JTech-CO/Smart-Cart-4/assets/reference/servo-performance.webp

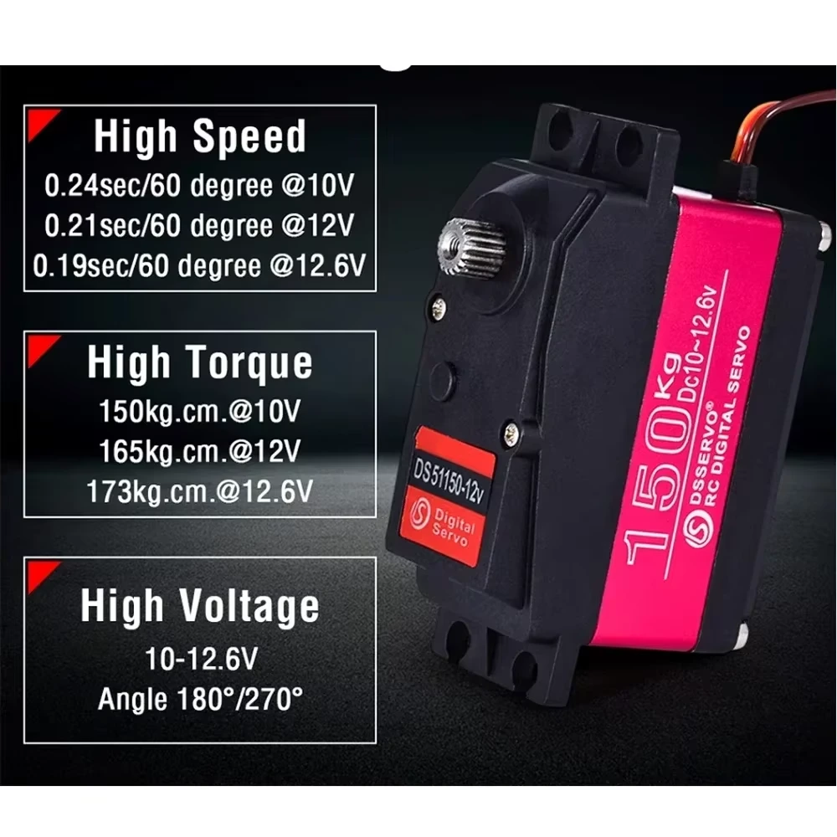
assets/reference/servo-performance.webp
