JTech-CO/Smart-Cart-4/assets/reference/servo-construction.webp

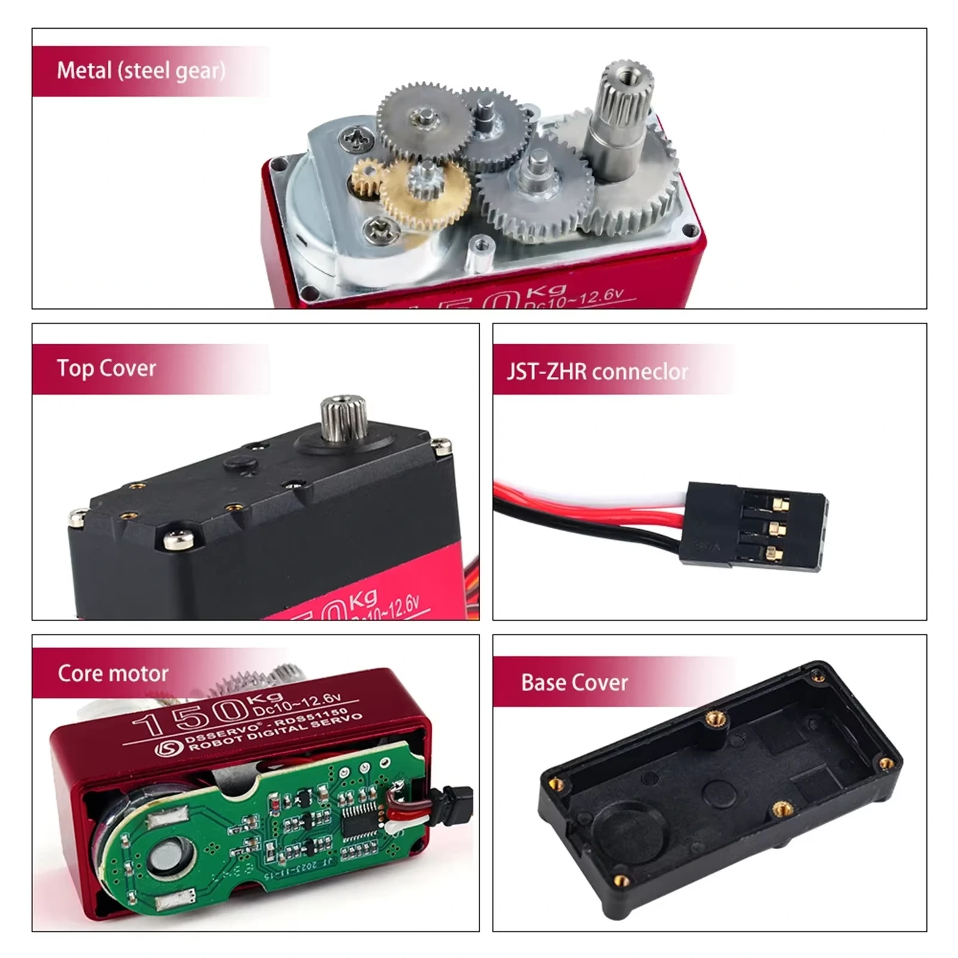
assets/reference/servo-construction.webp
