JTech-CO/Smart-Cart-4/SOURCE-NOTICE.md

# Source and rights notice

Base code: JTech-CO/Smart-Cart-3, frozen snapshot `688dbda586c06510763cf9cc42d9b45c1e14094f`, and the D4 files produced earlier in this conversation. The package does not claim a new license over upstream code.

The attached specification, servo photographs, source FreeCAD document and extracted product imagery were provided by the user. Product photos, logos and any third-party markings retain their original rights. No watermark or rights notice has been removed. Public redistribution rights must be confirmed separately. No system font files are distributed. Original upstream license metadata in FCStd is preserved.

D4.1 changes are local packaging, integrity, user-interface correction and test work. No remote repository was modified. Shape and connector depictions are placement aids, not manufacturer CAD or production drawings. No fabrication or energization release is granted.
