JTech-CO/Smart-Cart-4/docs/EVIDENCE-KR.md

# D4 근거와 미해결 충돌

기준: 사용자가 첨부한 `스마트카트_8종_부품상세사양_ESP수정.docx`(2026-09-14), RDS51150 사진 4개·본문 사양, `Full-scale concept.FCStd`, 앞서 생성한 D4 파일입니다. 이번 패키징은 새로운 실측이나 제조사 인증이 아닙니다. 원문 문서의 공식/요청/계열 참고/계산 구분을 유지합니다.

## 주요 반영

|항목|근거|패키지에서의 구분|
|---|---|---|
|Orange Pi 4 Pro|문서 1쪽, 89×56mm, DC5V/3A|입력 전원 규격이지 항상 3A를 소비한다는 뜻이 아님|
|MY1016Z|2~5쪽, 24V/13.4A, 120rpm 옵션|120rpm 무부하 표기, 스톨전류 미확정, 출력축 정격토크 임의 산출 금지|
|BU04 / BU03|6~7쪽, 별도 키트 PCB|공급 능력 ≥500mA와 평균 무선부 전류 구분; 태그 별도 전원|
|RPLIDAR C1|8쪽, 55.6×55.6×41.3mm / 43×43 M2.5|스캔 중심 0.862m는 배치 제안; 내부 나사 진입 최대4mm 조건 보존|
|WROOM-32U|9~11쪽, 2×19핀, CP2102, 외장 안테나|전체 보드 치수·USB 종류 미확정; GND/CMD 의심 핀 NC|
|XRY IBT-2|12~14쪽, 모듈 상한27V, HC244|43A 연속정격으로 표기하지 않음. AHCT 레벨 변환. IS ADC NC|
|RDS51150|15~16쪽 + 새 사진/본문|새 제공값과 DS51150 계열 참고값을 구분. 스톨8A를 확정하지 않음|

## 값이 충돌하는 부분

[기계 판독 근거표](../data/evidence-register.json)에 본문 서보 52×30×65mm, 사진 65.39/48.10/62.17mm, 리드 320/307mm, JST-ZHR/JR 3핀 표기, 모터 출력축 44/45mm, 원본과 D4 적재판 치수를 따로 보존했습니다. 하나의 정확한 제작 치수로 통합하지 않았습니다. 3D 서보 외피 65.39×30×48.10mm는 모델링 선택값이며 실측 승인이 아닙니다.

사진의 PWM 3.3~5V·500~2500µs 표기와 실제 입력 HIGH 보증값·전원 범위는 구분해야 합니다. 기본 50Hz·1500µs에서 제한 범위로 시험하는 제안은 제어 펌웨어의 구현 완료를 뜻하지 않습니다.

## 복구한 사진

`assets/reference/doc-01.webp`~`doc-14.webp`는 첨부 DOCX의 이미지 등장 순서에서 추출했습니다. `servo-*.webp` 4개는 사용자 제공 사진입니다. 원문 DOCX는 수정하지 않았으며, 이미지 추출 목록과 원본 SHA-256은 [input-manifest.json](input-manifest.json)에 기록했습니다. 원본의 워터마크나 제품 표기는 제거하지 않았습니다. 이미지의 제3자 권리를 새로 부여하지 않습니다.
