JTech-CO/Smart-Cart-4/docs/SAFETY-REVIEW-KR.md

# D4 설계 보류 조건

**소프트웨어 회귀검증 통과는 전기적 안전 인증이나 통전 승인이 아닙니다. JDRV OPEN, ENGINEERING HOLD를 유지합니다.**

## G01 배터리와 IBT-2 전압 부적합

배터리 실모델 미정. 8S LiFePO4 29.2V는판매상한27V 초과.

해소 조건: JDRV OPEN 유지. 배터리 상한/회생 여유를 검증한 호환 전원 또는 드라이버 변경 승인. 단순 과전압 차단기만으로 호환되지 않음.

## G02 구동모터·IBT-2 열/전류 정격

정격13.4A, 스톨전류불명. 43A 연속정격 근거없음.

해소 조건: 기동/부하전류, 단자/PCB/방열 온도, 퓨즈시간-전류 및 차단용량 검증.

## G03 실물 단자 확인

ESP32 GND/CMD 충돌, IBT-2 전력단자순서불명.

해소 조건: 무전원 도통검사, 실제 보드 앞뒤사진/회로 대조. 의심GND사용금지. IS ADC미연결.

## G04 부팅·전원 순서·PWM/EN

AHCT/IBT 논리5V 및 ESP3.3V 도메인. 웹앱에 제어펌웨어없음.

해소 조건: /OE 기본HIGH, EN기본LOW, RPWM/LPWM초기LOW, 소프트웨어timeout/재부팅/USB분리 시험. 양방향PWM 동시명령 금지.

## G05 서보 실모델·배선·기구 끝점

스톨8A는다른계열 참고. 180/270옵션 및 커넥터미정.

해소 조건: 10~12.6V실품확인, 커넥터정격/전류실측, 좌우각교정 및 기계적멈춤. 서보축으로 차중지지금지.

## G06 회생·잔류전압·제동

전원차단은기계제동아님. 흡수기정격미정.

해소 조건: 로컬DC링크 흡수에너지/트립전압/냉각, 정지거리, 기계브레이크 검증. 승차/경사시험금지.

## G07 안전정지 부품 선정

SR1,K1/K2는기능요구 모듈이며확정모델아님.

해소 조건: 2채널NC, 수동리셋, EDM NC미러접점, DC차단 정격/코일전압/억제기 시험.

## G08 5V·USB·LiDAR 기동

C1 4.8~5.2V, 기동800mA대표;포트전류미정.

해소 조건: C1센서단 전압/리플≤150mV, 허브역급전/과전류/포트별전원 시험; USB와헤더중복급전금지.

## G09 기구 치수 충돌

서보본문/사진 축정의불일치, 모터44/45mm, ESP전체치수없음.

해소 조건: 실물측정후장착홀/스플라인/허브/브래킷 확정. C1M2.5내부진입≤4mm.

## G10 센서 가림·낙차 감지

ToF전방, 낙차감지안됨. 낮은LiDAR도프레임/적재물차폐가능.

해소 조건: 장애물높이/검은물체/유리/태그상실테스트. BU03/BU04펌웨어호환 및 RF안테나간섭 확인.

## G11 FreeCAD 원본과 D4 형상

원본은900×600deck, D3은다른사진기반비율.

해소 조건: 원본군은변경없이숨겨보존. D4재구성은별도그룹이며용접/구조/간섭설계승인이아님.

## 시험의 경계

이번 파일 검사는 부품/단자/NET/좌표/페이지 기능의 일관성을 확인합니다. 퓨즈 시간-전류 협조, 단락 차단용량, 케이블 전류·발열, BMS 차단, 코일 탈락시간, 회생 에너지, 모터 스톨, 제동거리, 조향 간섭·하중은 실물에서 검증하지 않았습니다. 단순히 체크박스를 전부 선택해도 HOLD는 해제되지 않습니다.

배터리 전압 호환을 해결하기 위해 JDRV를 닫는 것은 허용된 수정이 아닙니다. JDRV는 전압 조정기나 보호회로가 아니라 분리 링크입니다. 기존 24V 안전전원·코일 구성과 별도의 12V 서보 전원을 혼동하지 않습니다. 신호 접지·USB·브레드보드를 모터/서보 전력 귀환 경로로 사용하지 않습니다. 안전릴레이, 접촉기, 보호 소자는 구체적인 제품·정격 확정 전의 기능 요구 모델입니다.
