JTech-CO/Smart-Cart-4/docs/SOURCES.md

# Source register

The user-supplied document/images and frozen D4 files are the basis for this packaging task. External URLs below are inherited provenance links, not newly downloaded or independently reverified in this task. Source document section/page references in component descriptions are textual provenance, not manufacturer approval.

- **DOC8**: [첨부 스마트카트 주요 부품8종 상세사양 (ESP수정)](../docs/EVIDENCE-KR.md)
- **SV-PHOTOS**: [사용자 제공 RDS51150 사진4종 및본문사양](../assets/reference/servo-dimensions.webp)
- **TI-AHCT**: [TI SN74AHCT125 Rev.R](https://www.ti.com/lit/ds/symlink/sn74ahct125.pdf)
- **TI-ISO**: [TI ISO7720F Rev.G (D3 계승)](https://www.ti.com/lit/ds/symlink/iso7720.pdf)
- **ESP**: [Espressif DevKitC V4 비교자료 (클론핀맵보증아님)](https://docs.espressif.com/projects/esp-dev-kits/en/latest/esp32/esp32-devkitc/user_guide.html)
- **REPO**: [JTech-CO/Smart-Cart-3 snapshot](https://github.com/JTech-CO/Smart-Cart-3/tree/688dbda586c06510763cf9cc42d9b45c1e14094f)
- **R2**: [Smart-Cart-Wiring / B1 assembly conditions [D3 inherited reference]](https://github.com/JTech-CO/Smart-Cart-Wiring/blob/3ac3f1d793caba6494d27df6f0b9ba2eee8606d5/docs/ASSEMBLY-KR.md)
- **R3**: [Smart-Cart-BOM / C1 procurement reconciliation [D3 inherited reference]](https://github.com/JTech-CO/Smart-Cart-BOM/blob/26c5061ff08912abb77f7fafcdc5e83a1018ac98/Smart-Cart-Procurement-BOM.md)
- **S1**: [Pololu SMC G2 user guide [D3 inherited reference]](https://www.pololu.com/docs/0j77/all)
- **S3**: [Adafruit BNO085 #4754 / pinouts [D3 inherited reference]](https://learn.adafruit.com/adafruit-9-dof-orientation-imu-fusion-breakout-bno085/pinouts)
- **S4**: [Pololu VL53L1X #3415 / connections [D3 inherited reference]](https://www.pololu.com/product/3415)
- **S5**: [TI TCA9548A / Rev. H datasheet [D3 inherited reference]](https://www.ti.com/lit/ds/symlink/tca9548a.pdf)
- **S7**: [SLAMTEC RPLIDAR C1 / specifications [D3 inherited reference]](https://www.slamtec.com/ko/c1/spec)
- **S8**: [Pilz / safety relay function [D3 inherited reference]](https://www.pilz.com/en-INT/support/lexicon/articles/072106)
- **S9**: [Pilz / feedback loop monitoring [D3 inherited reference]](https://www.pilz.com/en-INT/support/lexicon/articles/074070)
- **R4**: [Smart-Cart-2 / inspected D2 snapshot [D3 inherited reference]](https://github.com/JTech-CO/Smart-Cart-2/tree/cf2a2bd5bced9a97989de4bb2a884ecbb5e389a2)
- **S11**: [TI ISO7720 / dual forward channels, F default-low option [D3 inherited reference]](https://www.ti.com/product/ISO7720)
- **S12**: [TI ISO772x Rev.G / pin configuration and supply decoupling [D3 inherited reference]](https://www.ti.com/lit/ds/symlink/iso7720.pdf)
