JTech-CO/Smart-Cart-4/assets/previews/3d-desktop.png

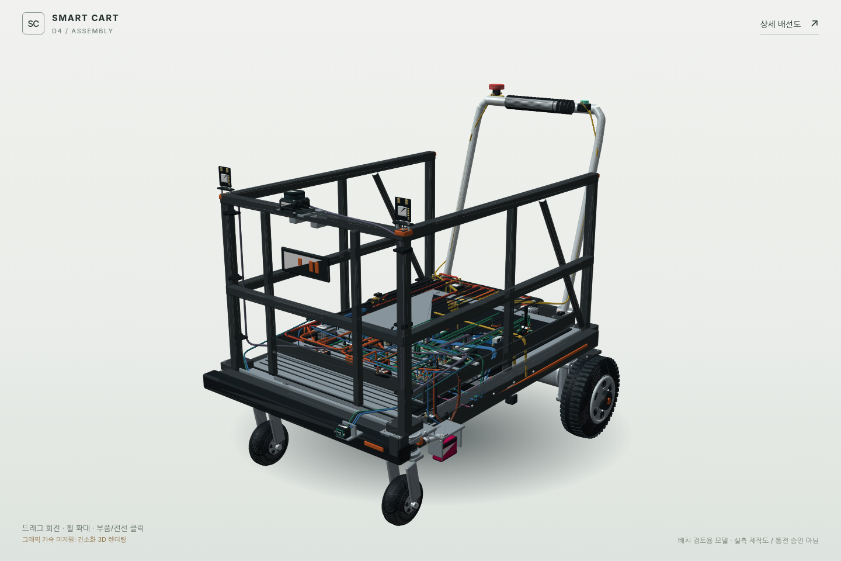
assets/previews/3d-desktop.png
