JTech-CO/Smart-Cart-4/assets/previews/3d-front-detail.png

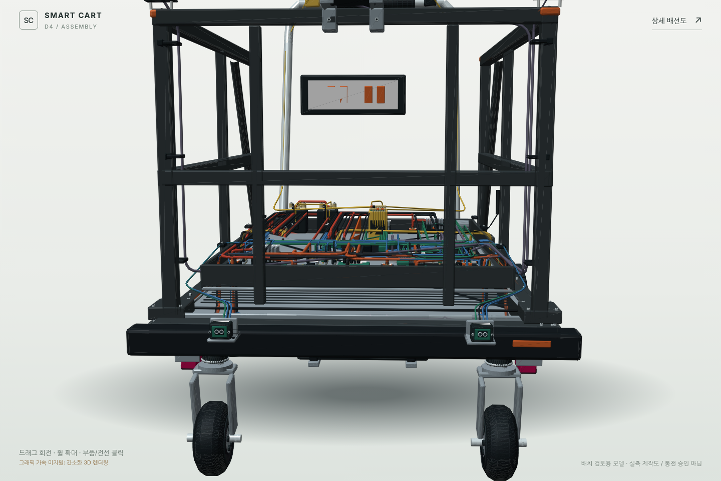
assets/previews/3d-front-detail.png
