JTech-CO/Smart-Cart-4/assets/previews/3d-mobile.png

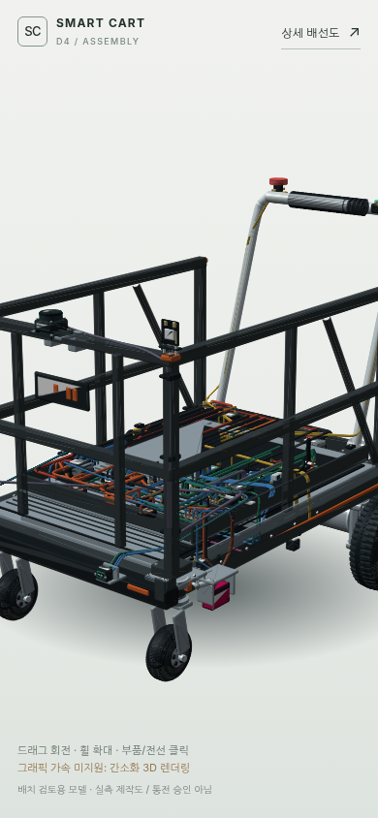
assets/previews/3d-mobile.png
