JTech-CO/Smart-Cart-4/assets/previews/3d-servo-selected.png

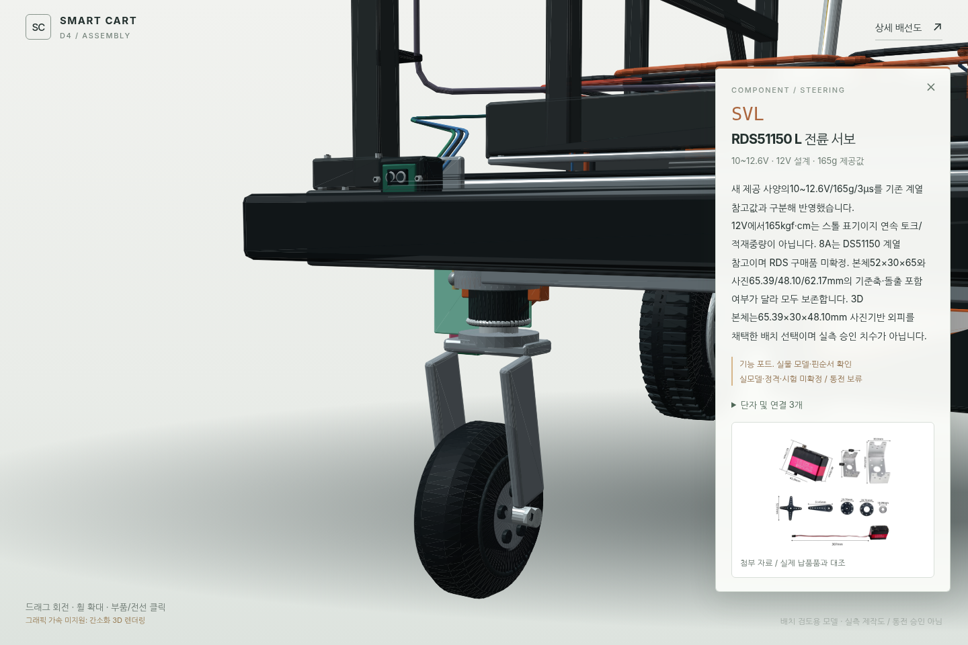
assets/previews/3d-servo-selected.png
