JTech-CO/Smart-Cart-4/assets/previews/3d-small-mobile.png

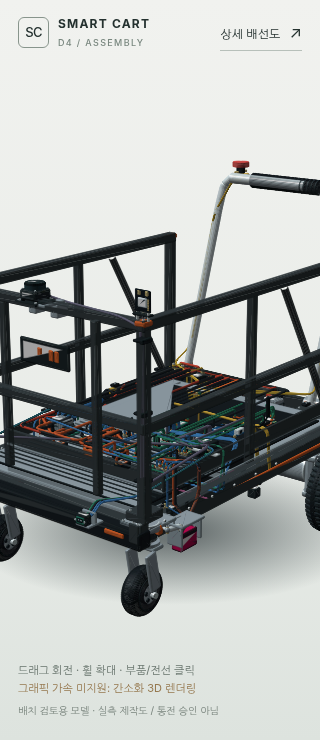
assets/previews/3d-small-mobile.png
