JTech-CO/Smart-Cart-4/assets/previews/3d-tablet.png

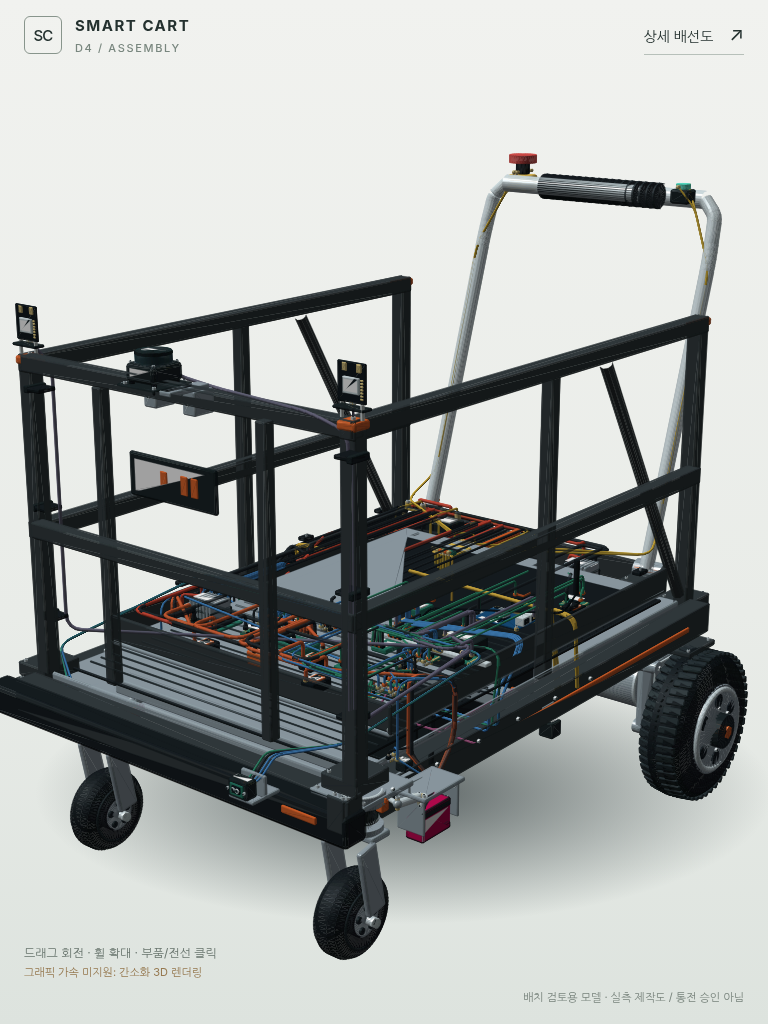
assets/previews/3d-tablet.png
