JTech-CO/Smart-Cart-4/assets/previews/screenshot.png

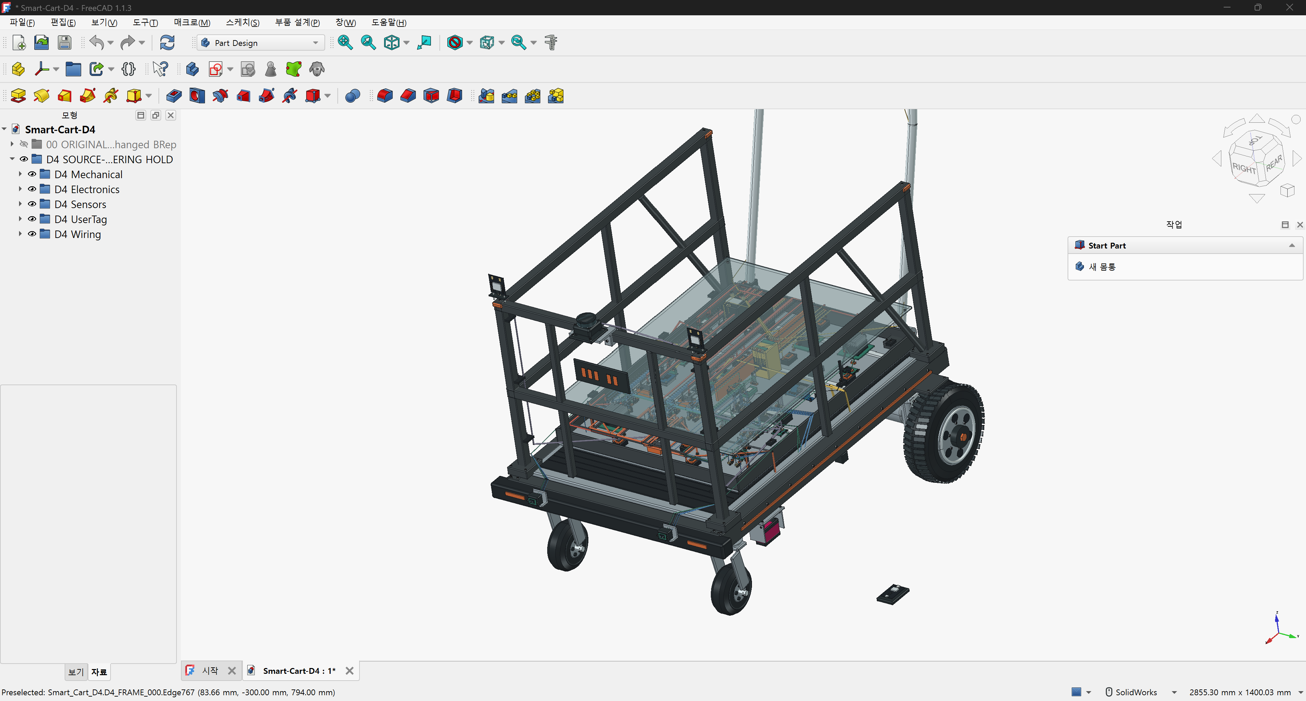
assets/previews/screenshot.png
