JTech-CO/Smart-Cart-4/assets/reference/doc-01.webp

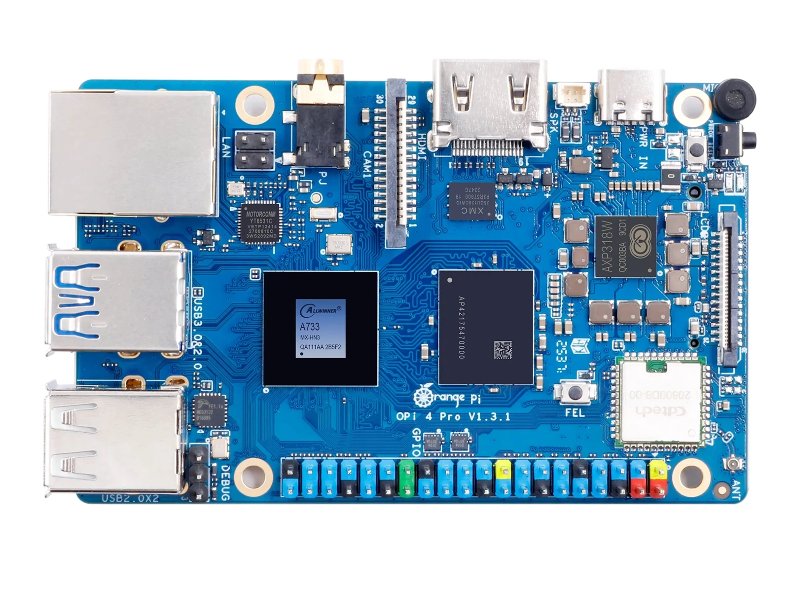
assets/reference/doc-01.webp
