JTech-CO/Smart-Cart-4/assets/reference/doc-02.webp

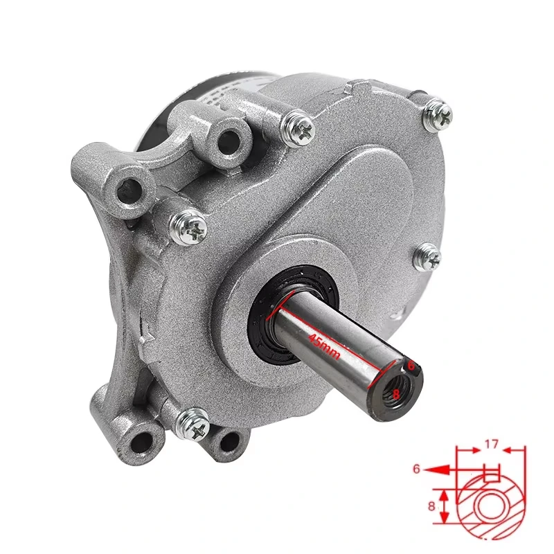
assets/reference/doc-02.webp
