JTech-CO/Smart-Cart-4/assets/reference/doc-03.webp

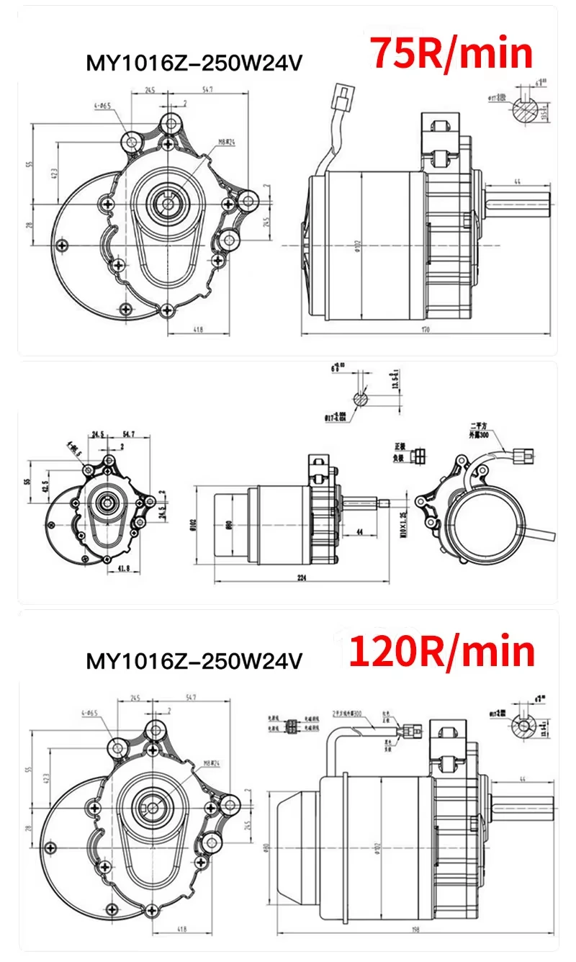
assets/reference/doc-03.webp
