JTech-CO/Smart-Cart-4/assets/reference/doc-05.webp

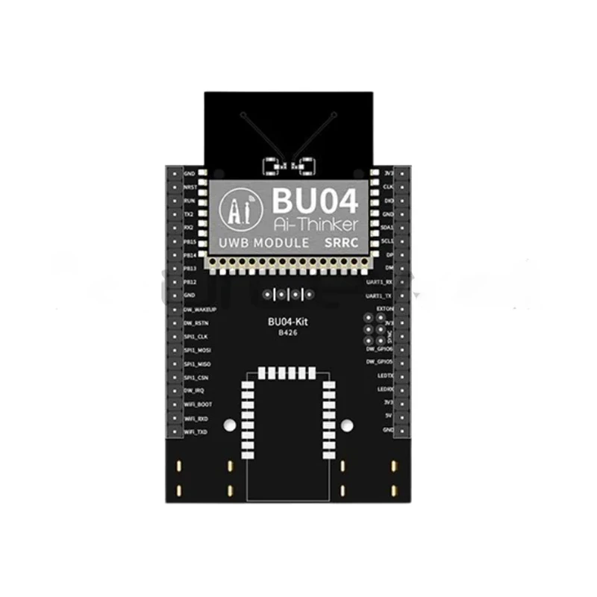
assets/reference/doc-05.webp
