JTech-CO/Smart-Cart-4/assets/reference/doc-07.webp

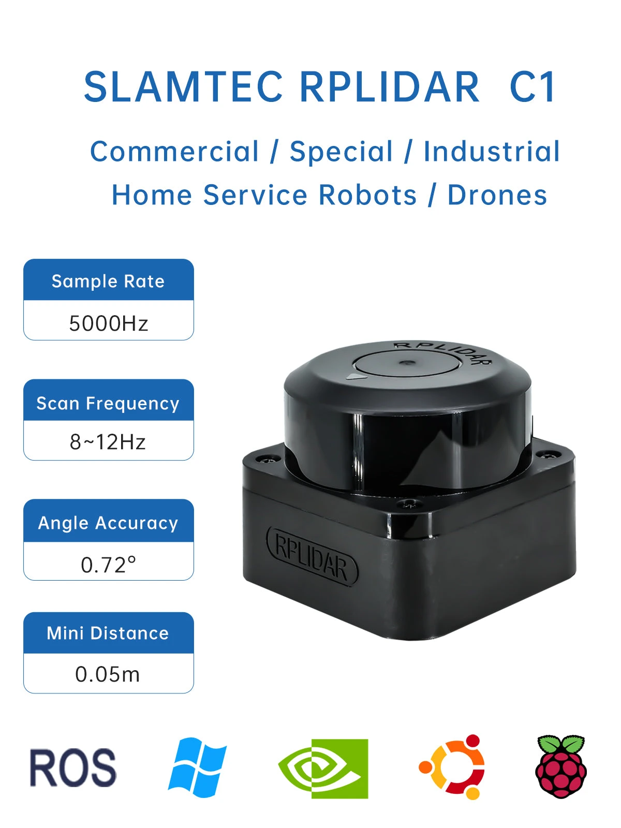
assets/reference/doc-07.webp
