JTech-CO/Smart-Cart-4/assets/reference/doc-08.webp

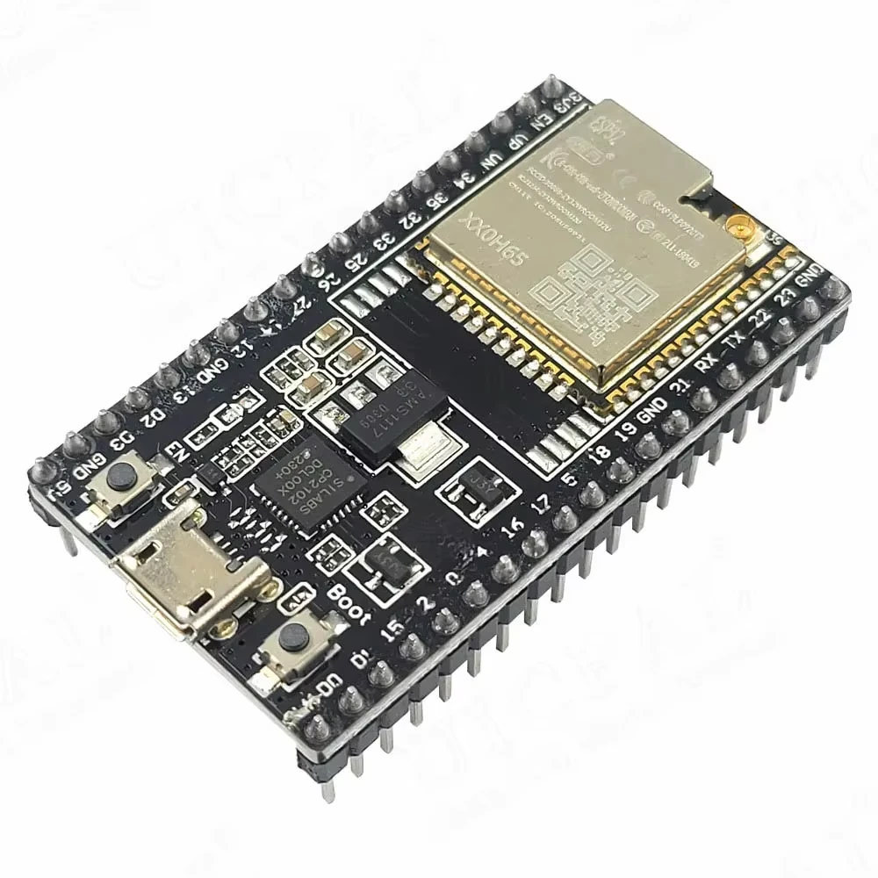
assets/reference/doc-08.webp
