JTech-CO/Smart-Cart-4/assets/reference/doc-09.webp

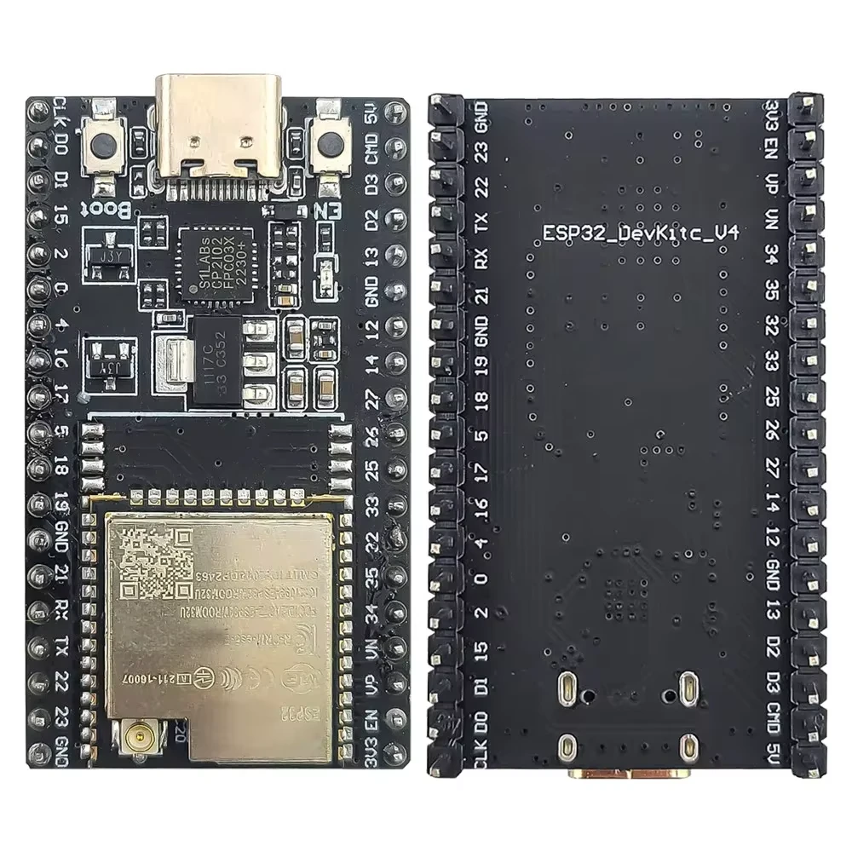
assets/reference/doc-09.webp
