JTech-CO/Smart-Cart-4/assets/reference/doc-10.webp

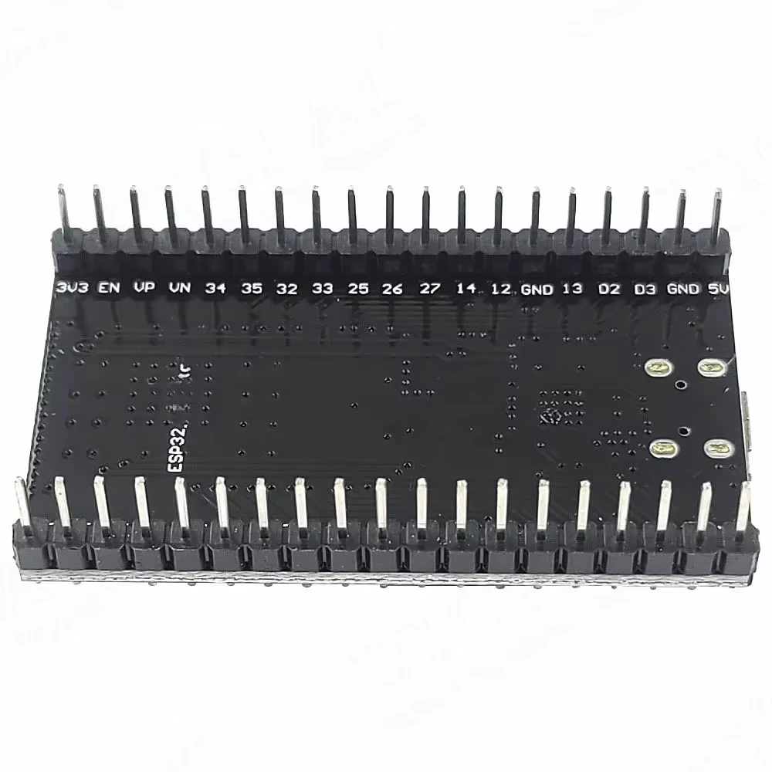
assets/reference/doc-10.webp
