JTech-CO/Smart-Cart-4/assets/reference/doc-11.webp

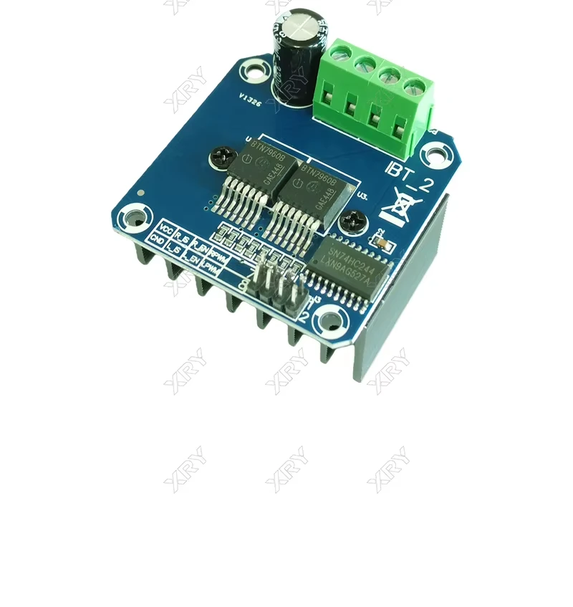
assets/reference/doc-11.webp
