JTech-CO/Smart-Cart-4/assets/reference/doc-13.webp

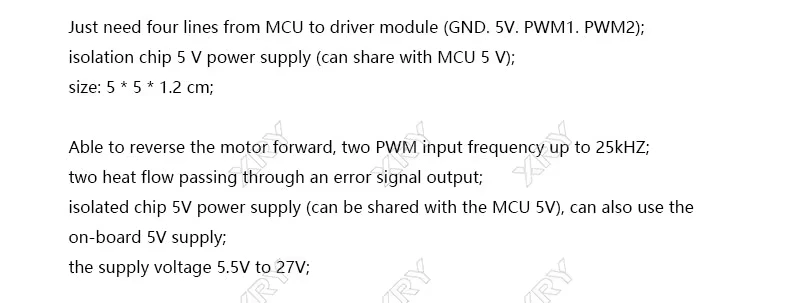
assets/reference/doc-13.webp
