JTech-CO/Smart-Cart-4/assets/reference/doc-14.webp

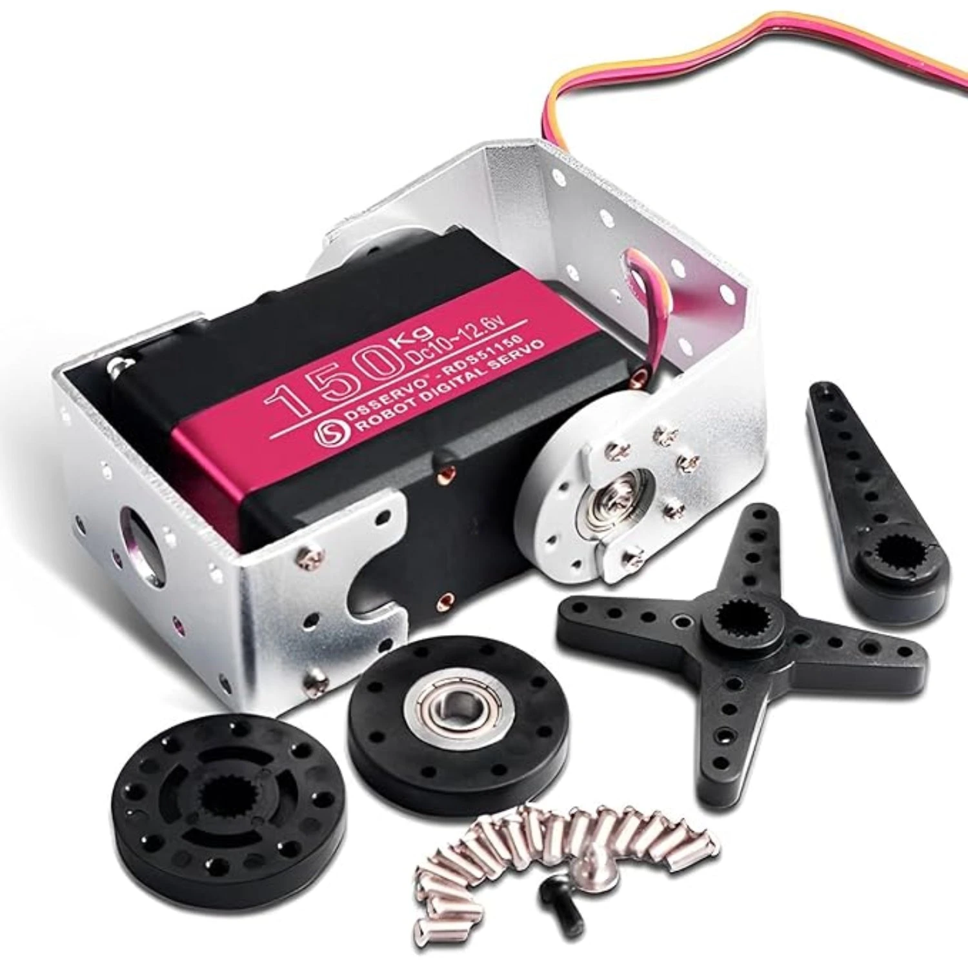
assets/reference/doc-14.webp
