JTech-CO/Smart-Cart-4/assets/reference/servo-dimensions.webp

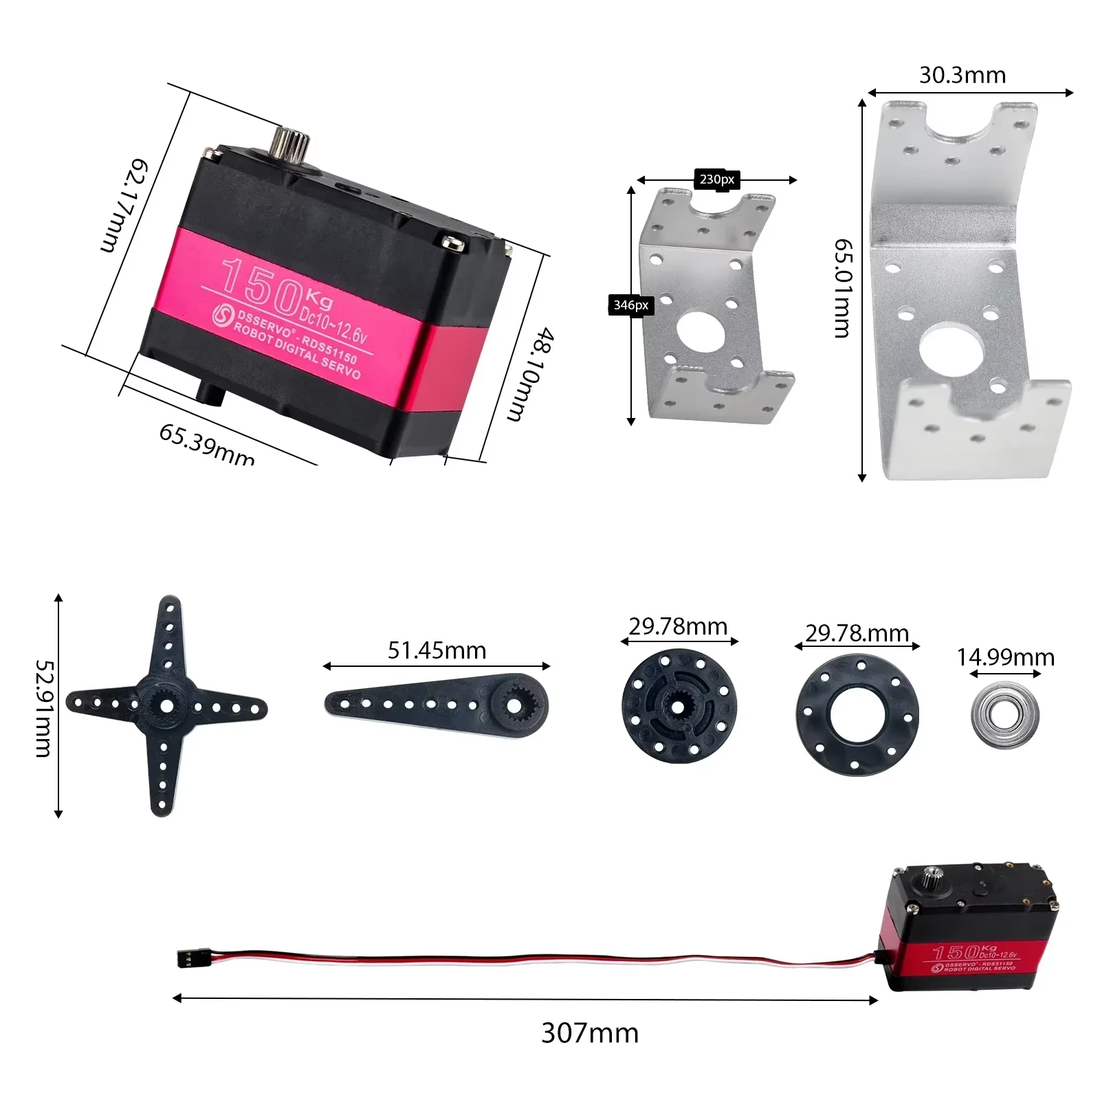
assets/reference/servo-dimensions.webp
