JTech-CO/Smart-Cart-4/assets/reference/servo-pwm.webp

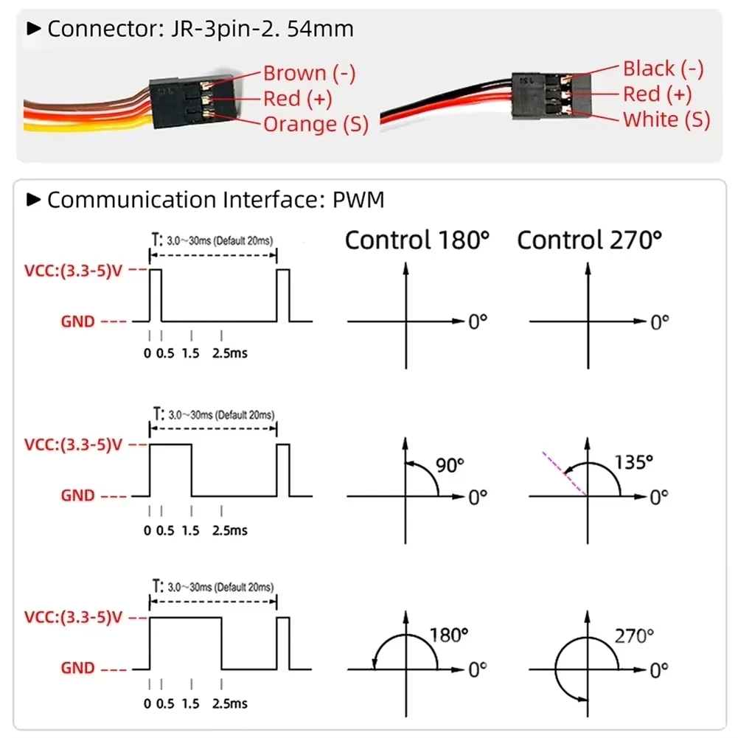
assets/reference/servo-pwm.webp
