JTech-CO/Smart-Cart-4/cad/Smart-Cart-D4.FCStd

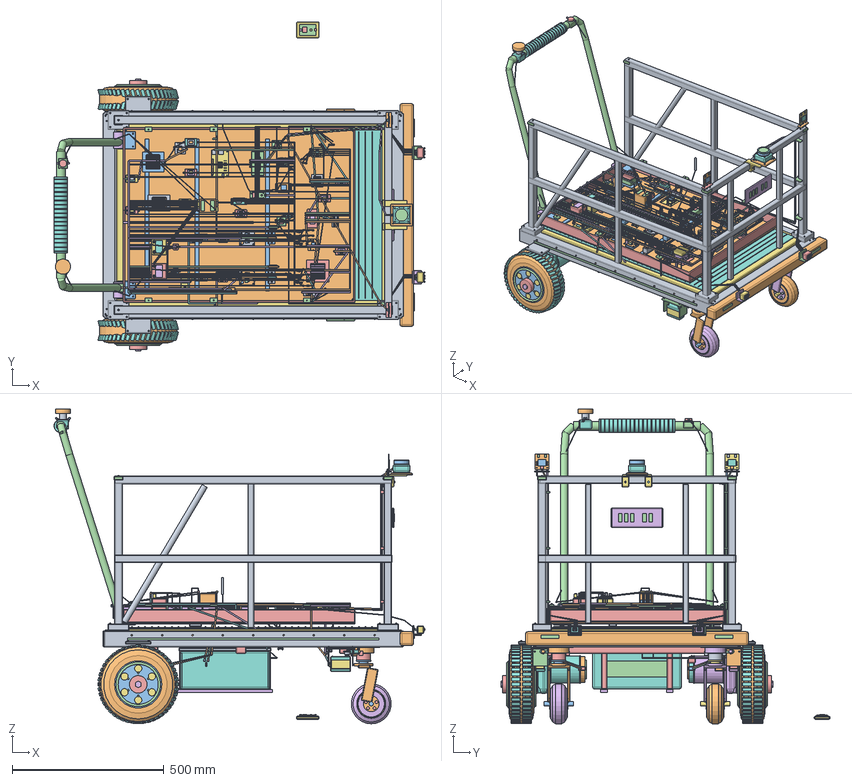
[picture p23: CAD file, 2026-09-14]
cad/Smart-Cart-D4.FCStd
1222.8 x 1084.0 x 1037.0 mm
FRAME | FRAME x 7
DECK | DECK x 3
HANDLE | HANDLE x 7
WHEEL_L | WHEEL_L x 8
WHEEL_R | WHEEL_R x 8
CASTER_L | CASTER_L x 7
LINK_L | LINK_L x 5
CASTER_R | CASTER_R x 7
LINK_R | LINK_R x 5
TRAY | TRAY x 5
LIDAR_MOUNT | LIDAR_MOUNT x 5
CLAMPS | CLAMPS x 4
ML | MY1016Z L 감속모터 x 6
MR | MY1016Z R 감속모터 x 6
SVL | RDS51150 L 전륜 서보 x 6
SVR | RDS51150 R 전륜 서보 x 6
BT1 | 배터리 + BMS x 8
OP1 | Orange Pi 4 Pro 6GB x 6
U1 | ESP32-WROOM-32U 38핀 x 7
MDL | XRY IBT-2 L 드라이버 x 8
MDR | XRY IBT-2 R 드라이버 x 8
F0 | 메인 DC 퓨즈 x 3
S0 | 주전원 차단기 x 3
X24 | 절연 + 분배 블록 x 3
X0 | 0V 스타 분배 블록 x 3
K1 | 주접촉기 1 x 6
Z1 | 코일 억제기 1 x 4
K2 | 주접촉기 2 x 6
Z2 | 코일 억제기 2 x 4
F1 | L 구동 분기 퓨즈 x 4
PPL | 프리차지 L x 3
CLL | DC 링크 흡수기 L x 4
RBL | 링크 잔류전압 방전 L x 3
CML | 모터 노이즈 억제 L x 3
F2 | R 구동 분기 퓨즈 x 4
PPR | 프리차지 R x 3
CLR | DC 링크 흡수기 R x 4
RBR | 링크 잔류전압 방전 R x 3
CMR | 모터 노이즈 억제 R x 3
F3 | 안전전원 입력 퓨즈 x 4
DC1 | 안전전원 DC-DC x 6
F9 | 안전전원 출력 퓨즈 x 3
SR1 | 이중 채널 안전릴레이 x 6
S1 | 비상정지 x 4
S2 | 수동 리셋 x 3
F4 | 5V 컨버터 입력 퓨즈 x 4
DC2 | 제어전원 DC-DC x 6
OV5 | 5V 독립 과전압 보호 x 4
F7 | SBC 5V 분기 퓨즈 x 3
F8 | 허브 5V 분기 퓨즈 x 3
H1 | 외부전원 USB 허브 x 5
X3 | 센서 3.3V/0V 분배 x 4
RP_SDA | 풀업 SDA x 3
RP_SCL | 풀업 SCL x 3
RP_RST | 풀업 MUX_RST x 3
RP_INT | 풀업 IMU_INT x 3
CH1 | 충전 전용 커넥터 x 3
FCH | 충전 분기 퓨즈 x 4
F11 | 조향 입력 퓨즈 x 4
DC3 | 서보 전용 DC-DC x 5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
