JTech-CO/Smart-Cart-4/cad/source-prototype.FCStd

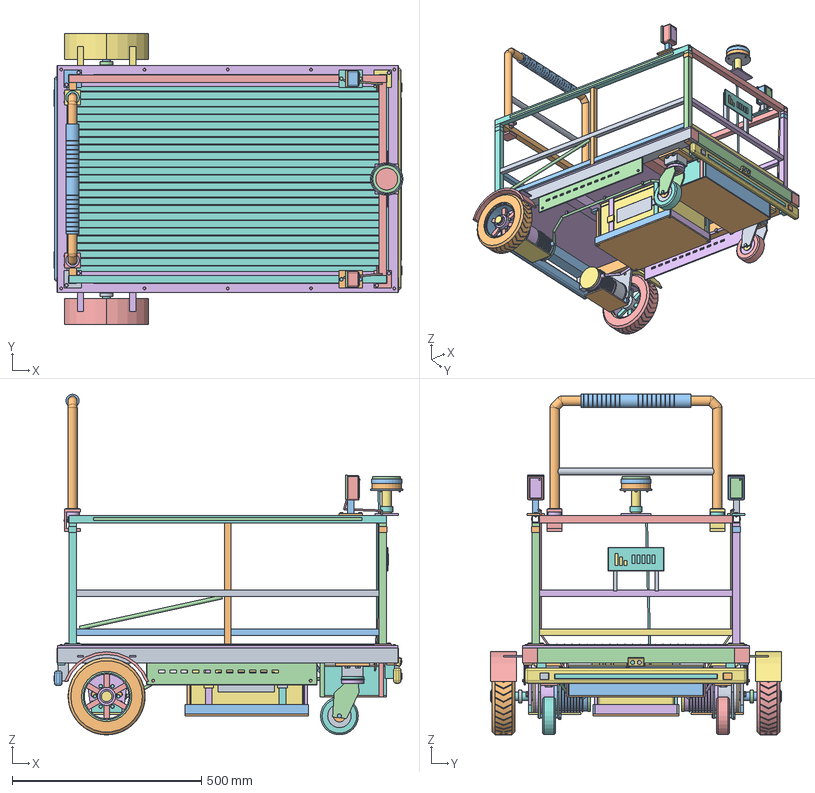
[picture p24: CAD file, 2026-09-14]
cad/source-prototype.FCStd
922.0 x 770.0 x 900.0 mm
Right chassis side | hollow RHS 40 x 40 x 2
Left chassis side | hollow RHS 40 x 40 x 2
Rear frame crossmember | RHS 40 x 40 x 2
Front frame crossmember | RHS 40 x 40 x 2
BatteryFront frame crossmember | RHS 40 x 40 x 2
BatteryRear frame crossmember | RHS 40 x 40 x 2
CasterBridge frame crossmember | RHS 40 x 40 x 2
Welded frame corner gusset
Welded frame corner gusset001
Welded frame corner gusset002
Welded frame corner gusset003
Sealed RHS end caps
Sealed RHS end caps001
Right welded motor support | bored shaft + mounting holes
Right lower motor saddle
Right saddle to motor plate bracket
Left welded motor support | bored shaft + mounting holes
Left lower motor saddle
Left saddle to motor plate bracket
Rear enclosure support brackets
Front enclosure support brackets
Right splash guard mounting brackets
Left splash guard mounting brackets
Front bumper stand-off brackets
Rear bumper support brackets
Right drive tire | 203.2 x 60 mm
Right alloy rim barrel
Right machined rim lips
Right six spoke wheel center
Right wheel hub and keyed shaft boss
Right orange hub cap
Right hub fasteners
Right tire molded sidewall bead
Right tire valve
Right 24 V gearmotor body | dimensional placeholder
Right motor rear cover
Right motor cooling bands
Right gearbox housing
Right gearbox face plate
Right shaft | coaxial with wheel
Right shaft retaining collar
Right motor support fasteners
Right motor cable gland
Right motor data label placeholder
Left drive tire | 203.2 x 60 mm
Left alloy rim barrel
Left machined rim lips
Left six spoke wheel center
Left wheel hub and keyed shaft boss
Left orange hub cap
Left hub fasteners
Left tire molded sidewall bead
Left tire valve
Left 24 V gearmotor body | dimensional placeholder
Left motor rear cover
Left motor cooling bands
Left gearbox housing
Left gearbox face plate
Left shaft | coaxial with wheel
Left shaft retaining collar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
