JTech-CO/Smart-Cart-4/(list of files, cad)

Other CAD files:
cad/Smart-Cart-D4-Only.FCStd
