JTech-CO/Smart-Cart-4/wiring.html

SCJTECH / SMART CARTENGINEERING WORKBENCH · D4

ENGINEERING HOLD출처검증 조건 11

통전 보류부품 실모델·보호 정격·회생 및 제동 검증 전에는 배터리를 연결하지 마세요. 이 페이지는 제작 승인도가 아닙니다.보류 사유 ↗

01 / ASSEMBLY WIRING

# 부품을 보고, 단자끼리 연결

실물형 부품 배치와 회로 도식을 전환하세요. 부품·전선을 클릭하면 단자별 연결과 3D 위치를 확인할 수 있습니다.

108전장 참조 부품

246연결 경로

0.862 m상단 스캔 중심 제안

부품 배치회로 도식동일한 결선 데이터 · 외형 및 단자 위치는 예시

D4 · 부품 배치 / 실물 핀 순서 아님＋－전체 맞춤SVG 저장연결 ID0V 귀환

구동 전력안전정지저전압신호USB0V교차점은 접속 아님 · 포트 접점만 연결

POINT-TO-POINT / ONE SOURCE OF TRUTH

## 단자별 연결 목록

선 색상보다 W번호 · 출발 단자 · 도착 단자 · NET을 우선 확인합니다.

결선표 CSV 다운로드

246 / 246

ID | 출발 / FROM | 도착 / TO | NET · 유형 | 전선 규격 | 연결 조건 | 3D

주의: 기능 단자명은 제품 실크/핀번호와 다를 수 있습니다. 'HOLD' 회로의 제작·통전 승인을 의미하지 않습니다.

COMMISSIONING RECORD / LOCAL ONLY

## 첫 통전 전, 단계별 검증 기록

체크와 메모는 이 브라우저에만 저장됩니다. 모두 체크해도 설계 승인 상태는 HOLD로 유지됩니다.

점검 기록 JSON 저장

0 / 11 기록설계 상태: HOLD실물 검증·담당자 승인 별도기록 초기화

소프트웨어 상태 도식은 실제 안전릴레이/MCU 구현이 아닙니다. 전류 제한 전원, 보호구, 비상 조치와 제작 책임자의 감독 아래 시험해야 합니다.

JTech-CO / Smart Cart D4 · 2026.09.14 · Smart-Cart-3 기반 · 패키지 D4.1동작 명령 없는 정적 뷰어 · 치수/단자 위치는 시각화 추정 · 설계 검토 문서 ↗
