JTech-CO/Smart-Cart-4/assets/previews/wiring-desktop.png

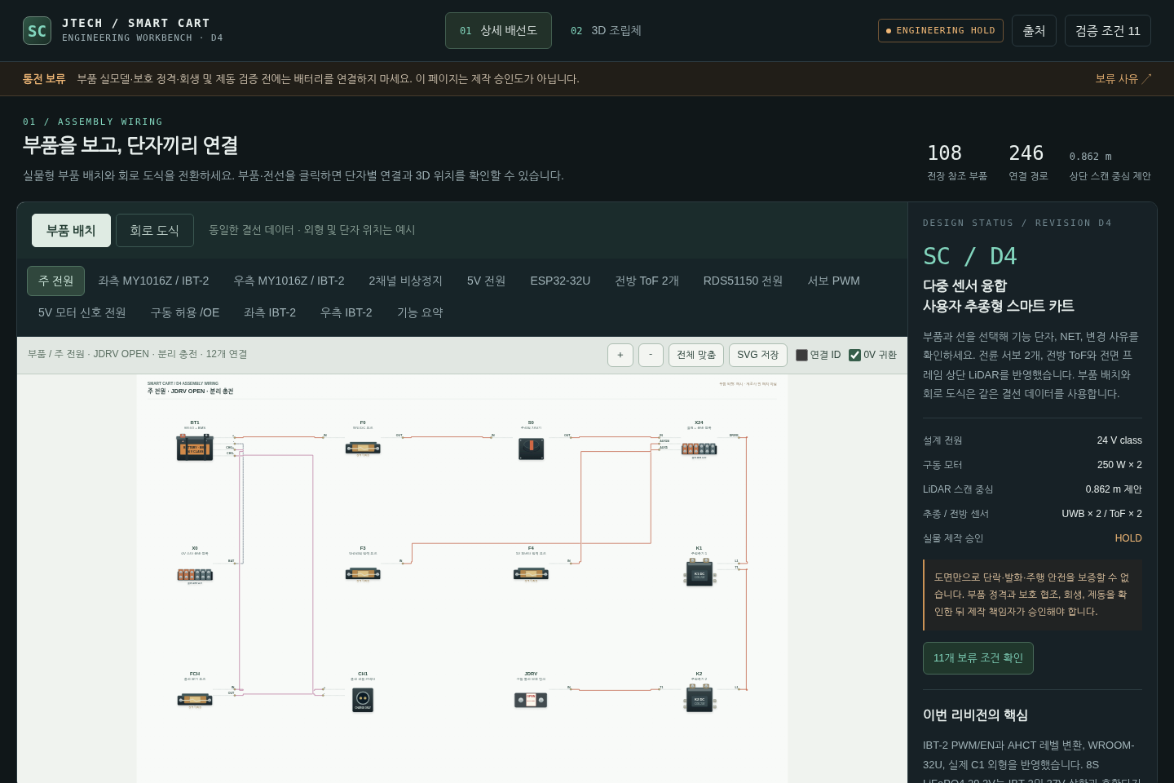
assets/previews/wiring-desktop.png
