JTech-CO/Smart-Cart-4/assets/previews/wiring-mobile.png

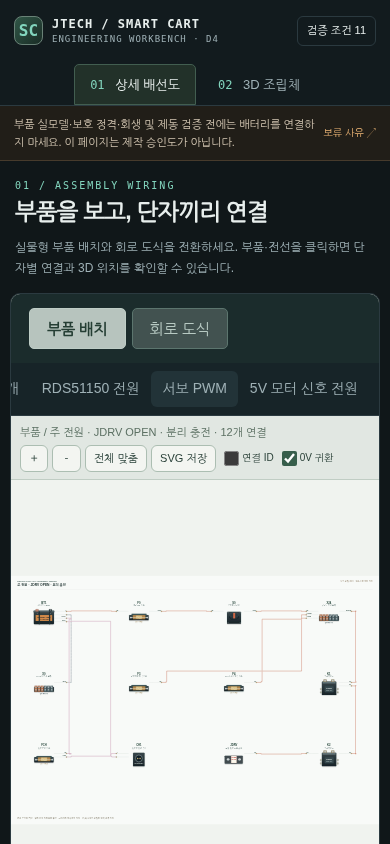
assets/previews/wiring-mobile.png
