JTech-CO/Smart-Cart-4/assets/previews/wiring-motor-pwm.png

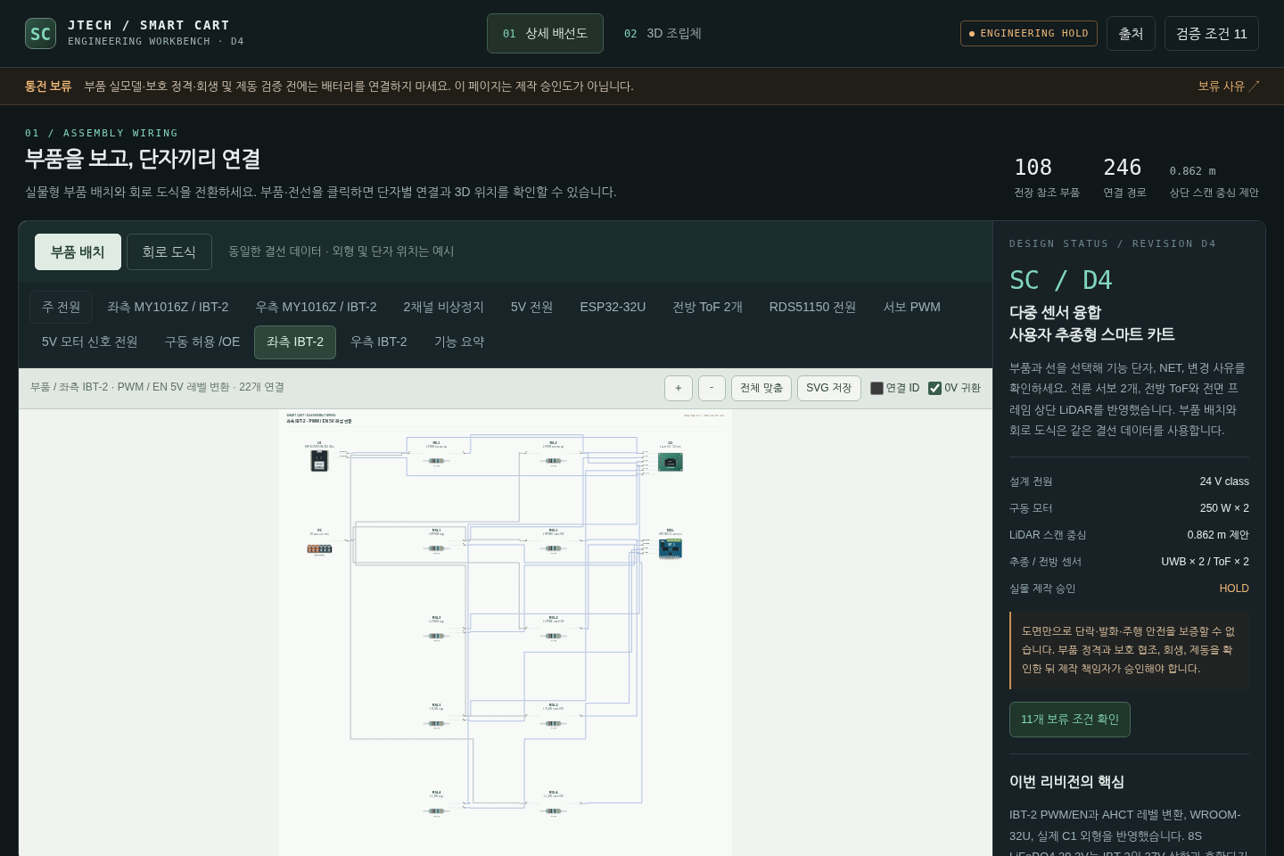
assets/previews/wiring-motor-pwm.png
