JTech-CO/Smart-Cart-4/assets/previews/wiring-servo.png

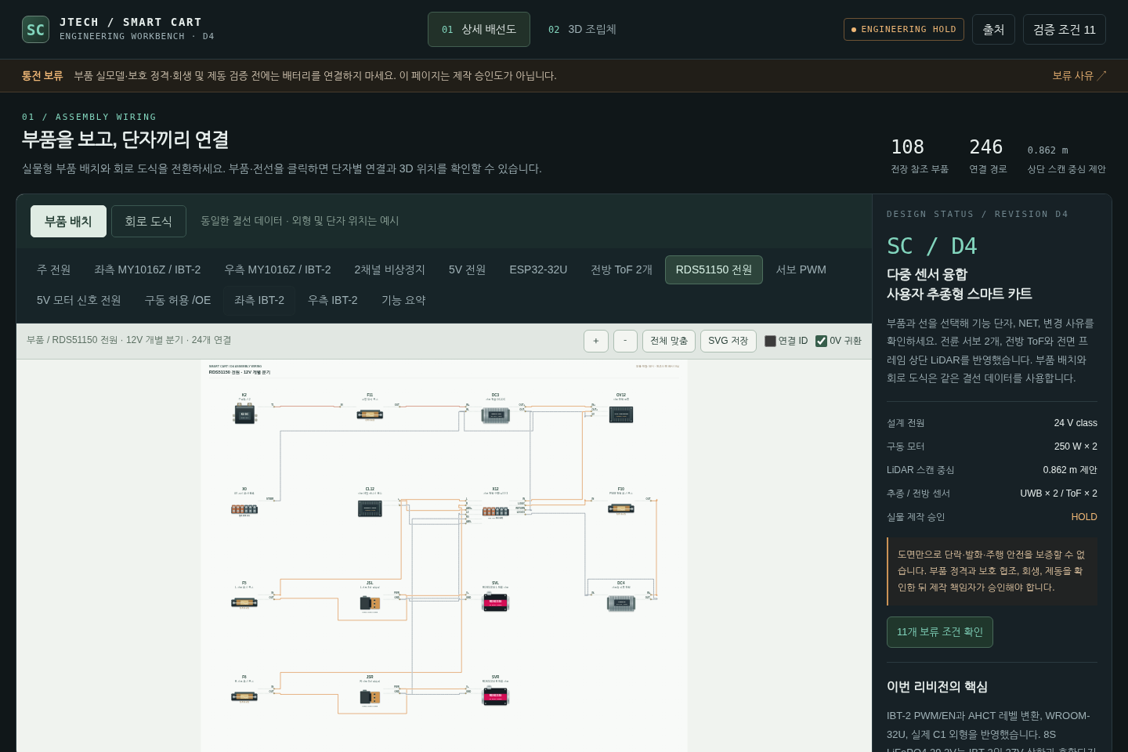
assets/previews/wiring-servo.png
