JTech-CO/Smart-Cart-4/assets/previews/wiring-small-mobile.png

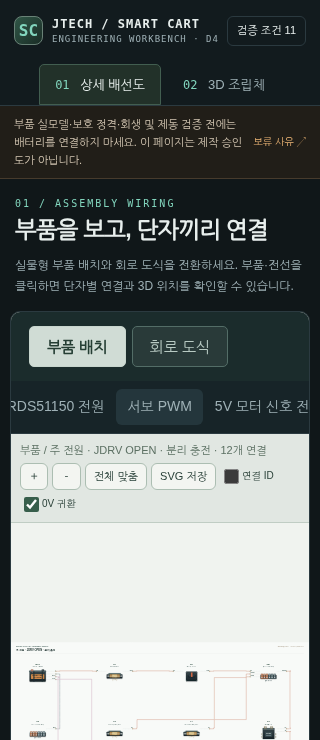
assets/previews/wiring-small-mobile.png
