JTech-CO/Smart-Cart-4/assets/previews/wiring-tablet.png

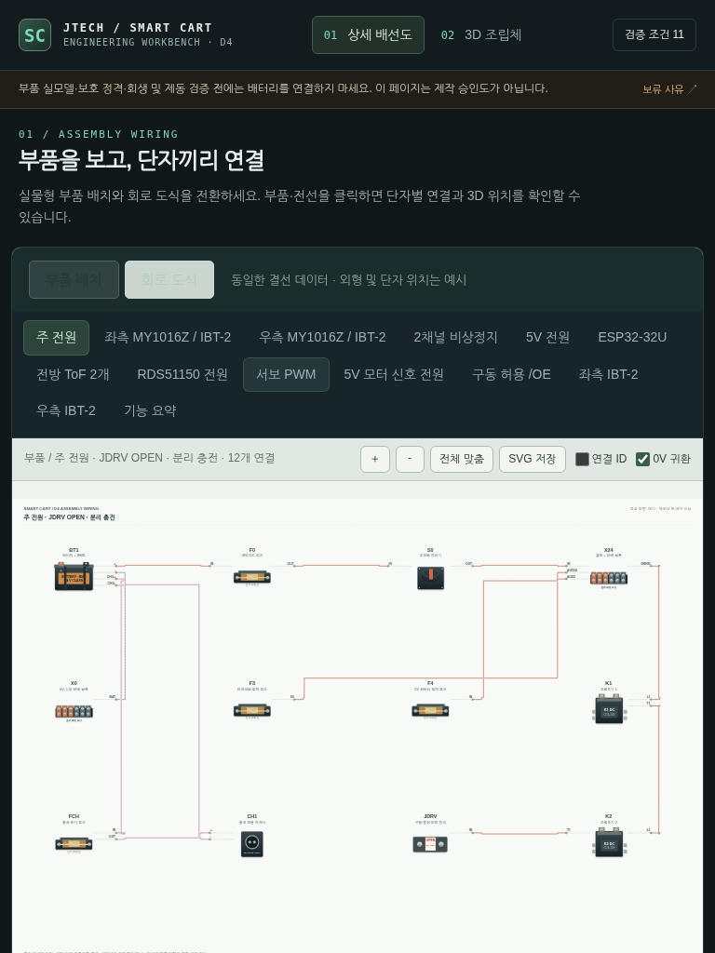
assets/previews/wiring-tablet.png
